mlcsoftware/C4iMonitorDC/Documentacion/STL/Carcaza superior.stl

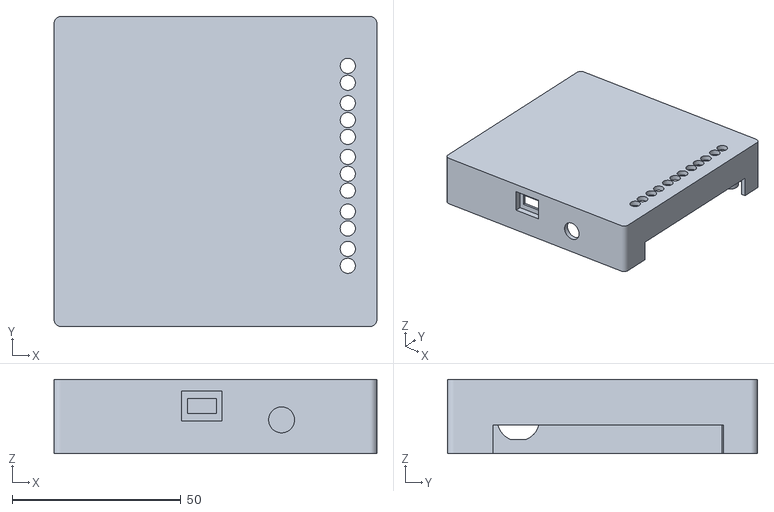
[picture p1: CAD file, 2026-01-07]
Documentacion/STL/Carcaza superior.stl
95.7 x 91.9 x 22.0
