mlcsoftware/C4iMonitorDC/Documentacion/STL/Logo+inscripciones.stl

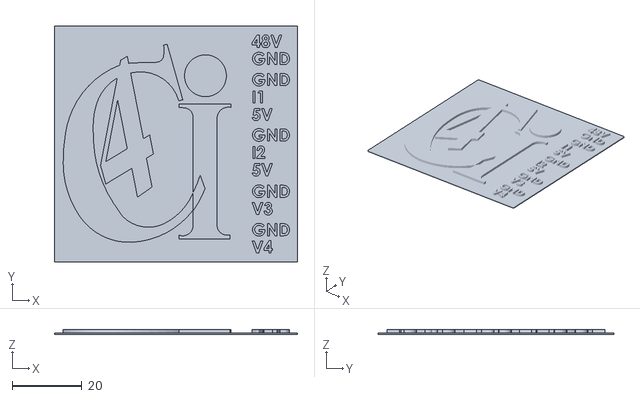
[picture p2: CAD file, 2026-01-07]
Documentacion/STL/Logo+inscripciones.stl
69.9 x 67.9 x 1.50
