mlcsoftware/C4iMonitorDC/Documentacion/STL/Carcaza inferior.stl

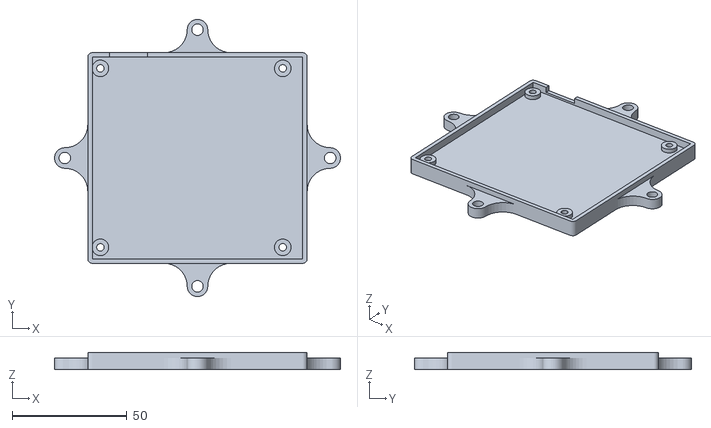
[picture p3: CAD file, 2026-01-07]
Documentacion/STL/Carcaza inferior.stl
124.7 x 120.9 x 7.60
