mlcsoftware/C4iMonitorDC/Documentacion/Schematics/Bottom Layer.pdf

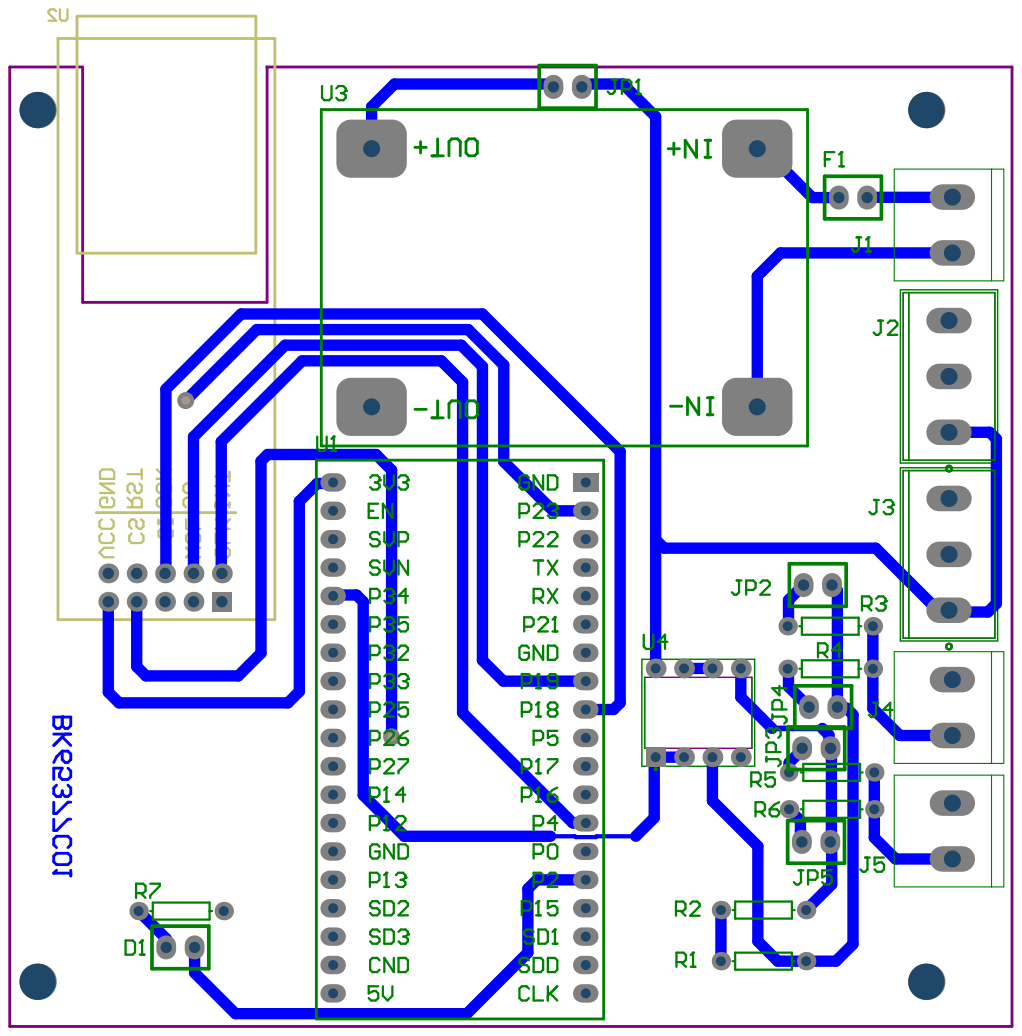
[picture p11: page 1]
