mlcsoftware/C4iMonitorDC/Documentacion/Schematics/Top Layer.pdf

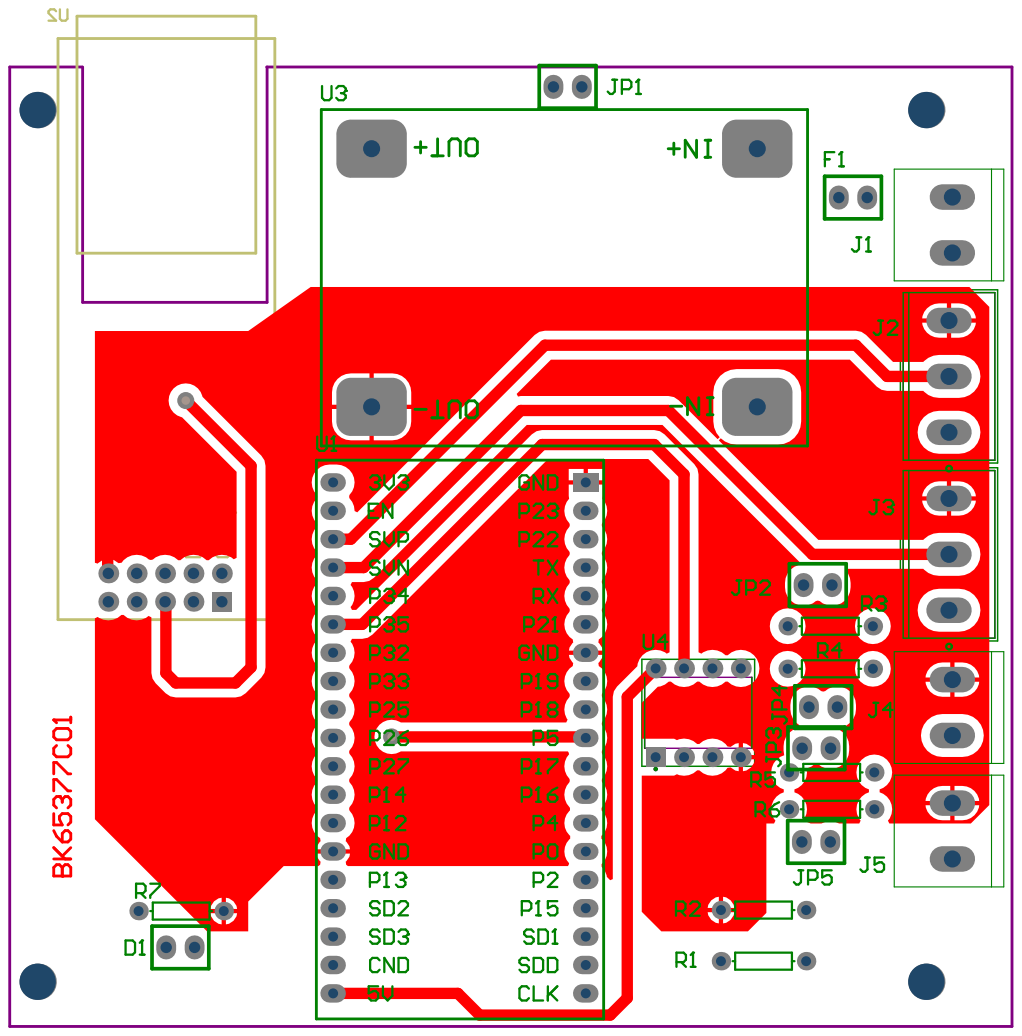
[picture p12: page 1]
