mlcsoftware/C4iMonitorDC/Documentacion/Schematics/Circuito esquematicoV2.pdf

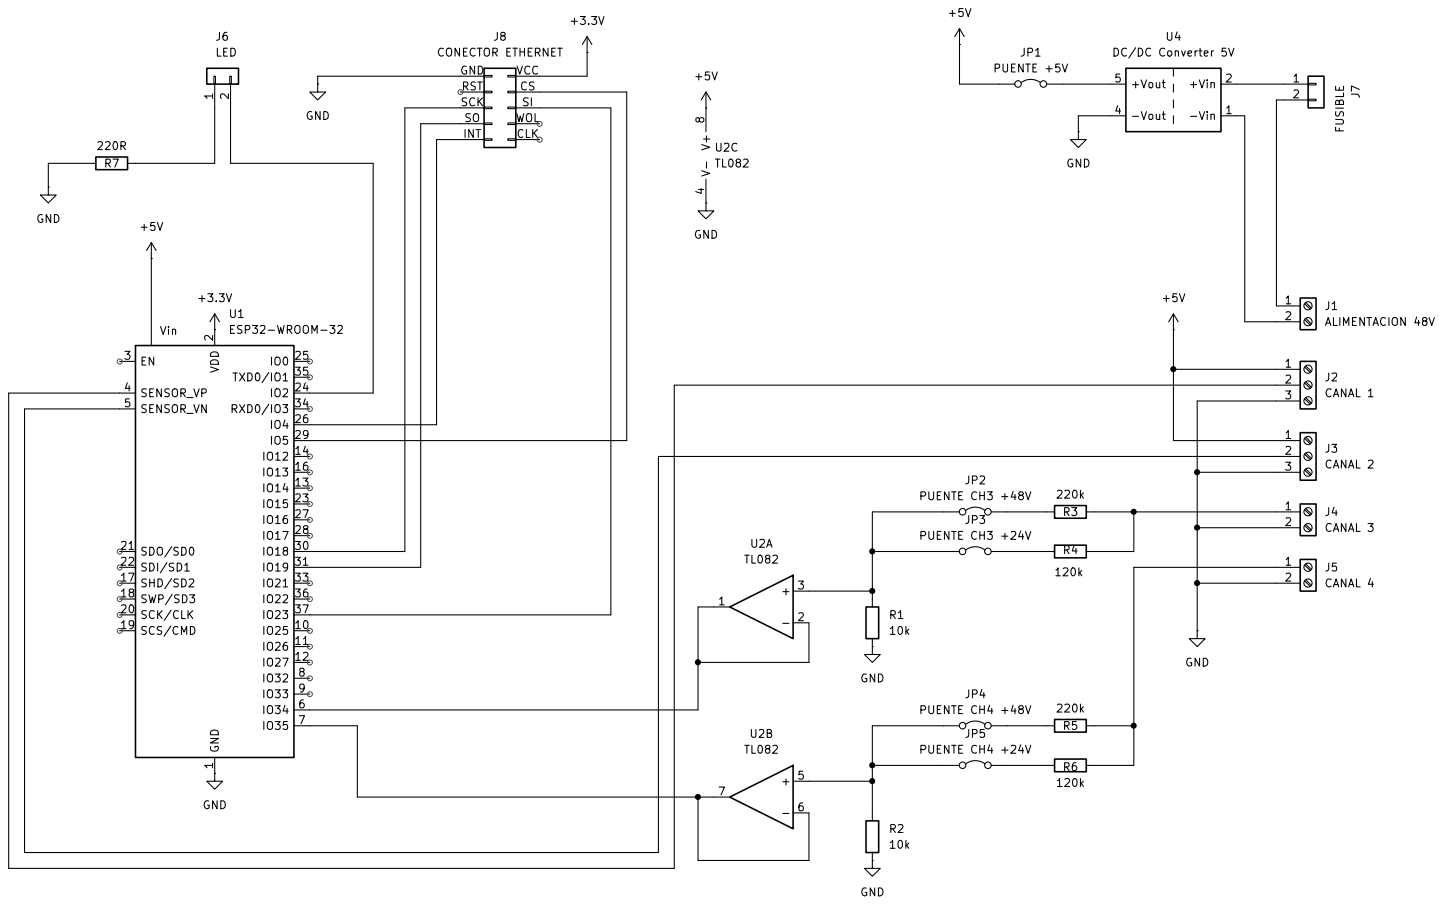
[picture p13: page 1]
