mlcsoftware/C4iMonitorDC/src/core/globals.h

#ifndef __GLOBALS_H_

#define __GLOBALS_H_

#endif

#include <WebServer_ESP32_ENC.h>
#include "core/Configuration.h"

Configuration glbConfig;
float CurrentCH1 = 0;
float CurrentCH2 = 0;
float VoltageCH3 = 0;
float VoltageCH4 = 0;
