mlcsoftware/C4iMonitorDC/(commit log)

2025-12-14 Primer commit Initial commit new file: src/Cli.h new file: src/core/Configuration.h new file: src/core/constants.h new file: src/core/globals.h new file: src/html/configuration.html new file: src/htm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
    [Configuration.h]
2025-12-27 Fix: Agrega comando para mostrar valor del canal en entero 12 bits
    [Configuration.h]
2025-12-27 Dev: Agrega calibracion
    [Configuration.h]
2026-01-04 Dev: Version 1.0.7. Limita el backspace y agrega comando incorrecto
2026-01-07 Agrega STL
    [Carcaza inferior.stl, Carcaza superior.stl, Logo+inscripciones.stl]
2026-01-13 Dev: Version 1.0.8 Agrega primer tramo a la curva
2026-03-06 Dev: Agrega esquematicos y pcb
    [solar.kicad_pcb, solar.kicad_sch]
2026-03-17 Dev: Agrega documentación PCB
2026-03-17 Dev: Agrega tensión de diferencia V3-V4
2026-03-25 Dev: Agrega documentación de PCB
2026-04-22 Fix: Agrega nueva versión de manual para corregir el OID de los queries de tensión
2026-04-27 Fix: Agrega actualización de manual
2026-04-27 Fix: Agrega valor de diferencia a OID
    [main.cpp]
2026-06-04 Elimina archivo incorrecto Documentacion/Schematics/solar.kicad_pcb
    [solar.kicad_pcb]
2026-06-04 Elimina archivo incorrecto Documentacion/Schematics/solar.kicad_sch
    [solar.kicad_sch]
2026-08-21 Fix: Agrega filtro umbral de corriente configurable
    [Configuration.h]
2026-08-22 Fix: Version 1.0.9. Agrega umbral de corriente configurable
    [constants.h]
2026-08-24 Fix: Corrije error de value no definido y numero fijo flotante.
    [Configuration.h]
